zomco/aiontheedge-firmware/cases/DESIGN.md

# 水表光学抄表装置 · 外壳设计文档

> **这是外壳设计的主文档。** 面向接手迭代的 AI 或工程师。
>
> 配套：`wmcase/`（参数化模型 + 自检套件）、[WORKFLOW.md](WORKFLOW.md)（迭代流程）、
> [ASSEMBLY.md](ASSEMBLY.md)（装配说明，由模型生成）、
> [DESIGN_NOTES.md](DESIGN_NOTES.md)（**历史与踩过的坑**，强烈建议先读它的 §7）。
>
> 本文回答"**为什么长这样**"；`params.py` 回答"**是多少**"；
> `checks/` 回答"**怎么知道它对**"。三者不重复，出现矛盾时以代码为准，
> 并**立刻回来改这份文档**。

---

## 目录

1. [项目背景与硬约束](#1-项目背景与硬约束)
2. [坐标系与命名约定](#2-坐标系与命名约定)
3. [数据台账：哪些数字可信](#3-数据台账哪些数字可信)
4. [光学设计](#4-光学设计)
5. [机械设计](#5-机械设计)
6. [防呆设计](#6-防呆设计)
7. [电气与固件接口](#7-电气与固件接口)
8. [代码结构](#8-代码结构)
9. [自检套件](#9-自检套件)
10. [未验证的假设](#10-未验证的假设)
11. [换开发板 / 换表型](#11-换开发板--换表型)
12. [协作规矩](#12-协作规矩)

---

## 1. 项目背景与硬约束

在**不更换既有水表**的前提下，给自建出租房的 **40 块机械水表**加装光学抄表装置，
读数回传 Home Assistant。

| 约束 | 值 | 来源 |
|---|---|---|
| 不能更换水表 | — | 业主要求 |
| 表盘上方净空 | **70mm**（40 台的**最小**值，自银圈顶面起算） | 实测 |
| 单机 BOM | 目标 ≤ 50 元 | 业主预算 |
| 必须保留人工抄表 | 每月 1 日 + 租户争议时 | 业主要求 |
| 端侧完成识别 | 只回传读数 | 业主要求 |

现场：楼梯半层，每层 6 块表垂直排列；表前方净空 1 米以上；
每层一路 5V/10A 电源；楼梯间潮湿（结露风险）。

被测表：宁波埃美柯 **LXSY-15E2**，DN15 旋翼式液封冷水表，
L=165 / B=94 / H=111，G3/4B（数据取自 `amico-lxsy.pdf` 外形尺寸表）。
表盘**朝上**，5 位字轮 + 4 个指针。

> **"表盘朝上"这一条是全设计的起点。** v0.1 曾经按"表盘朝外"设计，整版报废。
> 换表型时第一件要确认的就是这个姿态。

---

## 2. 坐标系与命名约定

**这一节是所有几何讨论的前提，任何时候不要改动。**

```
原点 O  = 水表表盘玻璃面的中心
+X      = 沿水表体轴线（左右方向），整机左右对称
+Y      = 离墙方向（房间一侧）；吊舱、滑盖抽出、整机拆卸都在这一侧
+Z      = 垂直向上；上方净空 70mm 是全项目最紧的约束
```

关键平面（`params.Meter` 的派生量，不要手写）：

| 特征 | Z |
|---|---|
| 表盘玻璃面 | 0 |
| 银圈顶面 | +7.0 |
| 银圈底部凸台顶 | −11.3 |
| 银圈底面 | −14.1 |
| **天花板（障碍物）** | **+77.0** |
| 镜面中心 = 镜头光轴 | +42.0 |
| 镜头前端面 | Y = +80.0 |

### 2.1 旋转必须写出映射并逆向验算

历史上最贵的一类错误是坐标变换复合写反（DESIGN_NOTES §7.1：
整个立板飞到别处，挂在上面的东西全部悬空）。现在的规矩：

**凡是涉及旋转/换系的地方，注释里必须写全映射，并把基准点代回去验算。**

代码里三处坐标系都照做了，格式如下（摘自 `layout.board_location`）：

```
局部 +Xs (PCB 长边)  -> 全局 -Z
局部 +Ys (板厚)      -> 全局 -Y
局部 +Zs (PCB 短边)  -> 全局 -X

逆向验算：Zs = axis_zs -> X = 0 ✓；Ys = lens_face_ys -> Y = 80 ✓；Xs = axis_xs -> Z = 42 ✓
行列式检查：det = +1（纯旋转）。若写成 ez→(+1,0,0)，det = −1 —— 那是镜像，
会把 SD 卡座和排针悄悄挪到另一侧，而板子近似左右对称，看渲染图发现不了。
```

行列式那一条不是形式主义：**开发板近似左右对称，镜像错了肉眼看不出来**，
但 SD 卡座、排针、天线座的位置会全错。

---

## 3. 数据台账：哪些数字可信

`params.py` 里每个字段都有可信度前缀。**改设计前先看清你依赖的是哪一类。**

| 前缀 | 含义 | 改动意味着 |
|---|---|---|
| `[实测]` | 卡尺量过 | 换了一块表 / 一块板 |
| `[采购]` | 规格书 / 样本 | 换了供应商 |
| `[设计]` | 我们自己定的 | **参数搜索的主战场** |
| `[估算]` | 还没验证的假设 | 见 [§10](#10-未验证的假设)，每条都有验证方法 |

### 3.1 表头实测（抱箍与光学的全部基准）

| 项 | 值 |
|---|---|
| 银圈外径 | **82.1 mm** ← 抱箍唯一基准 |
| 银圈内径 | 61.8 mm |
| 银圈高度 | 21.1 mm |
| 可视表盘直径 | **56.5 mm** ← 光学 ROI 基准 |
| 银圈底部凸台 | 宽 9.5 × 高 2.8 |
| 40 台最小净空 | **70 mm** |

### 3.2 开发板（`esp32s3cam-2.step` 实测）

这些数字是用 `python build.py inspect esp32s3cam-2.step` 从 STEP 里量出来的，
抄进了 `params.BoardSpec`；自检 `FIT-05` 会反过来核对，抄错会立刻报错。

| 项 | 值（STEP 局部坐标） |
|---|---|
| PCB | Xs 0→40，Zs 0→27，模型板厚 1.0（实物按 1.6 算间隙） |
| 光轴 | Xs = 8.91（这一侧朝上），Zs = 13.51（≈27/2，天然居中） |
| 镜头前端面 | Ys = 9.07（= 高出 PCB 面 8.07） |
| 摄像头模组本体 | 8.5 × 8.5，Ys 3.04→7.14；镜筒 Ø5.9 再往前 1.93 |
| 前侧深级（SD 卡座 + 排线） | 伸出 PCB 约 2.98mm，集中在 X ±8.3 |
| 前侧浅级（一圈贴片） | 伸出 PCB 约 1.54mm，一直铺到 X ±12.81 |
| 背面 | 模块 3.55mm，排针 9.02mm |

> **⚠ 一条重要修正。** 上一版文档写的是"摄像头模组 27×27mm"，
> 吊舱前腔就是按这个建的。实际从 STEP 量出来，模组本体只有 **8.5×8.5**，
> 27 是整块 PCB 的宽度。按 27 建的前腔既夹不住模组（光轴定位失效），
> 也挡不住 PCB（止挡失效）。**这是"从没验证过的假设"的典型代价。**

---

## 4. 光学设计

### 4.1 核心难题

表盘朝上，上方只有 70mm 净空，而相机需要 100mm 以上工作距离才有可用景深。

**解法：45° 前表面反射镜折叠光路。**

```
表盘 ──垂直上行 42mm──> 45° 反射镜 ──水平前行 80mm──> 镜头
```

总光程 **122mm**，但竖直方向只占用约 60mm；相机与电子件全部移到 +Y
（有 1 米净空），完全不占稀缺的竖直空间。

### 4.2 虚拟相机 —— 全部光学计算的基础

把镜头对 45° 镜面做镜像：

```
L  = (0, lens_face_y, mirror_z) = (0, 80, 42)
镜面：z − y = mirror_z，反射面法线 n = (0, 1, −1)/√2
L' = L − 2·((n̂·L − d)/|n̂|)·n̂ = (0, 0, mirror_z + lens_face_y) = (0, 0, 122)
```

**虚拟相机正悬在表盘中心上方 122mm 处，垂直向下看。**

于是"表盘上某点能不能被看到"退化成：**从该点连一条直线到 (0,0,122)**，
看它与镜面的交点是否落在镜片上、两段路径是否被挡。
三维折叠问题降成两段直线求交 —— `optics.py` 全部计算都基于这个等价。

反射方向验算（写出来接受检查）：

```
d_in = (0,0,1)（上行），n = (0,1,−1)/√2
d_out = d_in − 2(d_in·n)n = (0,0,1) + (0,1,−1) = (0,1,0)  ✓ 向 +Y 前行
```

### 4.3 光学参数与余量

| 量 | 值 | 判据式子 |
|---|---|---|
| 成像半径 ROI_R | 29 mm | 覆盖 Ø56.5 + 余量 |
| 总光程 | 122 mm | `mirror_z + lens_face_y` |
| 光锥在镜面处半径 | 19.02 mm | `roi_r·(1 − mirror_z/path)` |
| 45° 面与光锥交线 | Y ∈ [−24.95, +15.36] | 见 `Optics.ellipse_y` |
| **镜片光学需求** | 57 × 38 mm | `(y₁−y₀)·√2` × `2·beam_r` |
| **镜片采购规格** | **70 × 50 × 2 mm** | 余量 13 / 12 |
| 镜片**有效**口径 | 45.6 mm | 50 − 2×2.2（T 型槽唇口吃掉） |
| 单字符成像 | **44.4 px** | `digit_w·px_h / (2·path·tan(HFOV/2))` |
| 景深半宽 | ±20.5 mm | `N·c·s²/f²`，f=2.77mm，N=2.4，c=4.4µm |
| ROI 半张角 | 13.37° | `atan(roi_r/path)`，需 ≤ min(HFOV,VFOV)/2 = 25.97° |

> **"我算过了"不是证据。** 上表每一行都给出了式子，
> 而且都在 `checks/optical.py` 里有对应规则。
> 历史上至少两次因为手算式子写错而推翻了正确方案（DESIGN_NOTES §7.7）。

### 4.4 反射镜采购规格

| 项 | 要求 |
|---|---|
| 类型 | **前表面反射镜（第一表面镜）** |
| 尺寸 | 70 × 50 × 2 mm |
| 镀层 | 铝 + SiO₂ 保护膜 |
| 反射率 | 可见光 ≥ 88% |

**必须是前表面镜。** 普通背镀镜玻璃前后两次反射产生双像鬼影，
字轮出现重影，OCR 直接失效。镀膜面不可擦拭（只能气吹），
划伤即报废，**建议多买 2 片备用**。

> 曾经建议过"用报废机械硬盘盘片替代" —— **在这个尺寸下不成立**：
> 3.5" 盘片外径 95mm、中心孔 25mm，可用环带只有 35mm 宽，放不下 70×50，
> 而且中心孔会落在光路上。

### 4.5 眩光抑制

表盘是"Ø56.5、深 7mm 的井"，盖着弧面玻璃 + 液封介质。
**同轴照明（板载闪光灯）必然在字轮上打出镜面高光 —— 这是几何问题，调亮度无效。**

解法：**两颗 5mm 草帽白光 LED（120° 全角）置于 (±38, 0, 20)**，射向表盘中心。
（高度 30 → 20 是被托板的可拆性逼下来的，见 §5.3。）

| 检查 | 数值 | 判据 |
|---|---|---|
| 光线越过银圈内缘（ρ=28.25）时的高度 | 14.9 mm | `z(ρ) = z_led·ρ/R_led` |
| 表盘中心入射角 | 62.2° | 采集锥半角仅 13.4°，镜面反射瓣全部打偏 |
| 单颗在最外圈的阴影带 | 几 mm | `井深 × tan(入射角)`，由对侧那颗补上 |

**必须对置两颗，不是冗余而是几何必需。**
LED 型号必须是 **120° 草帽型**：普通 5mm 圆头只有 15~30°，
会打出中心亮斑、四个指针全黑。

**偏振片**：吊舱前壁留了 Ø20 × 1.2 沉孔作为对冲。默认不装；
若现场发现残余眩光，贴一片 Ø20 线偏振片 + LED 前贴一片旋 90° 即可。

### 4.6 ⚠ 画面是镜像的

光路含 **1 次反射**，传感器画面**左右翻转**。

* AI-on-the-edge 标 ROI 时看到的就是翻转后的画面，按翻转后的框；
* 如果要在固件里翻回来，OV2640 有 `set_hmirror()`，
  但**不要一边翻一边又按翻转后标 ROI**，两者只能选一个；
* `out/sensor_view.svg` 画的就是翻转后的画面，可以直接对照。

传感器长轴（1600px）到底对着全局 X 还是 Z，取决于模组内部芯片朝向，
**我们没有可信资料**。所以 `OPT-07` 的判据取 min(HFOV, VFOV)/2，
结论与朝向无关。第一台实物拍一张就能确定，确定后回来更新这一段。

---

## 5. 机械设计

### 5.1 三个打印件

| 件 | 体积 | 作用 |
|---|---|---|
| `body` | ≈129 cm³ | 抱箍 + 撑座 + 立板 + LED 座 + 镜托台 + 吊臂 + 吊舱（**单一连通实体**） |
| `mirror_holder` | ≈30 cm³ | 45° 托板 + 提手 + 两片支承片（**每月抄表整块提起**） |
| `slide_cover` | ≈8 cm³ | 竖直下滑，无螺丝 |

### 5.2 抱箍：整机唯一的机械接口

**曾经的致命错误**（DESIGN_NOTES §7.3）：内孔比银圈大 2.4mm，剖分缝只有 2.2mm，
完全闭合仅缩小 `2.2/π = 0.70mm`，**永远碰不到银圈**。
根源是假设了一个从未列入 BOM 的 1.2mm TPU 衬垫。

现在的方案：

| 项 | 值 | 理由 |
|---|---|---|
| 光孔 | Ø82.8（单边 +0.35） | 便于套入 |
| **16 条内棱** | 内切 Ø81.6（**单边过盈 0.25**） | 只有棱接触，局部压强高十几倍，抗转 |
| 剖分缝 | 4 mm | 留弹性张开行程 |
| 夹持带 | Z −10 ~ +6.5 | 高于底部凸台顶（−11.3），低于银圈顶（+7） |
| 夹紧螺栓 | 两颗 M4 蝶形，z = −6 / +2.5 | 上下受力均匀，防止带子张成 V 形 |
| 备用 | 前侧对称两个 Ø3.2 径向孔 | 棱纹不够时可拧 M4 自攻顶紧 |

**内棱的坑**：16 条棱里若有一条落在剖分缝内，会被切成孤立薄片。
代码里已加过滤，自检 `TOPO-01` 也会兜底。

**关于"校准固化"**：银圈顶部凹台位置逐台不同，说明表头装配角度本身随机，
所以**支架绝对朝向无法也不需要统一** —— 每台 ROI 本来就要在软件里各框一次。
需要保证的只是**同一台反复拆装后角度可复现**：靠抱箍不打滑 + 托板四点销定位。

### 5.3 镜片托板：等高四点支承 + 抬起平推

每月人工抄表时镜片挡住字轮，必须移开。
方案是**只取下这块托板**，而不是移动整个悬臂（那会破坏相机对位）。

动作只有两步：**垂直上提 8mm 脱离定位销 → 沿 +Y 平推出来。**

* 每侧一片**支承片**（X 32~38，厚 6），底边是一条**水平线**（z=20）；
* 落在立板伸出的**两个等高托台**上（都在 z=20）；
* 4 根竖直销约束平面内自由度（间隙 0.2，竖直销零支撑打印）；
* 读完原路放回，ROI 不需要重新标定。

#### ★ 为什么托台必须等高 —— 本次重构最重要的一条发现

上一版按"托板底面是 45° 斜面"的直觉，把前托台放在 z=50、后托台放在 z=20，
支承结构做成"三角耳 + 两只支承脚"。

**每个零件单独看都对，静态干涉检查全过 —— 但整块托板根本拿不出来。**

抽出时，支承结构的**后**半段要扫过**前**托台，而它比前托台低 30mm：

```
后支承脚底面 z = 20，前托台顶面 z = 50
要越过去需要抬升 > 30mm，而天花板只给 11mm
```

这个错误是 `SEQ-02`（抄表流程逐点路径仿真）抓到的。
**静态干涉检查一条都报不出来** —— 因为"装得进去"和"拿得出来"是两回事。

现在两个托台等高、支承片底边水平，抬 8mm 就整体脱离，平推无阻。

| 约束 | 值 | 由谁保证 |
|---|---|---|
| 两托台等高 | 都是 z=20 | `CONS-12` |
| 支承片底边水平且与托台等高 | z=20 | `CONS-12` |
| 支承片外缘 < 立板内侧面 | 38 < 42.5 | `CONS-11` |
| 支承片外缘 < LED 灯座最内缘 | 38 < 约 37.7+ | `SEQ-02` 路径仿真 |
| 托台内伸斜面免支撑 | atan(10.5/12) = 41.2° | `CONS-13` |

#### LED 高度被可拆性拉低了

灯座凸台会伸到 X≈37，正好落在支承片平推的路径上。
所以 LED 从 z=30 降到 **z=20**：凸台随之落到 z<27，支承片抬 8mm 后
（底面 z=28）刚好从它上面掠过。

**光学上反而更好**：表盘中心入射角从 51.7° 增到 62.2°，镜面反射瓣偏得更远；
掠射高度 14.9mm 仍远大于 7mm 井深。

### 5.4 提手：为什么在两边而不在中间

托板要能被一只手提起来，但三个约束同时卡着：

* **不能加高** —— 天花板只剩约 10mm 余量，竖直提手会把提起行程吃掉；
* **不能放中间** —— 中间是 T 型槽的插入口。横穿过去会被槽切断
  （实测：托板裂成 2 个孤立实体，`TOPO-01` 当场报错），也会挡住镜片滑入；
* **不能挡光**。

所以提手做成：两片从支承片前端伸出的**水平**悬臂（X ±32~38，y 18~34，z 58~64）
+ 一根横梁（y 28~34）。径向早已跑出光锥；横梁虽然过中心，
但 z 58~64 高于该处反射光束上缘（y=32 处约 53.8）。
立板前缘只到 y=22，所以横梁所在的 y 28~34 是完全敞开的，手伸得进去。

### 5.5 镜片 T 型槽

反射面朝下，直通方槽会让镜片掉出来。改成 T 型槽：

* 深部 50.2mm 宽容纳镜片；
* 开口收窄到 45.6mm，**两侧各留 2.2mm 唇口**；
* 从局部 −Y 一端滑入（全局方向为斜向上前方）。

**局部 z 的零点定义**（改之前必读 `parts/mirror_holder.py` 顶部）：

```
局部 z = +0.8   唇口外表面
局部 z =  0     ★ 镜片镀膜面 = 光学基准面 z = y + 42
局部 z = −2.0   镜片背面
局部 z = −4.5   托板背面
```

早期版本把零点定在"托板正面"，结果实际反射面比设计平面**退后 0.8mm**，
光线追踪直接打空 —— 这是个**只有射线求交才能发现**的错误，
体积布尔和肉眼都看不出来。

**镜片是在台面上装进托板的，不在现场装。**

### 5.6 滑盖：真正的 C 型槽

**曾经的错误**（DESIGN_NOTES §7.6）：槽只约束 X，盖板可以直接向后掉出来。

现在的结构（沿 Y 从前到后）：

```
Y  ~108.75   侧壁前沿      → 约束 −Y
Y 108.75~112.2  滑槽(X±19.5)  → 盖板舌片(X±19.3)在此，约束 X
Y 112.2~114  后压边(1.8mm) → 约束 +Y
```

盖板从顶部插入，竖直下滑，槽底限位。顶部有 Ø16 手指凹槽。

**主型腔必须贯通到吊舱后表面**，不能封死后端：推荐打印姿态下
（主体绕 X 轴 +90°，+Y 朝上）封死的后端会变成 34×66mm 的大平顶悬空，
远超 15mm 桥接上限。这是 DfAM 决定的结构，不是随便开的口。

### 5.7 吊舱：靠摄像头模组自己定位光轴

不用任何额外零件固定开发板。型腔沿 +Y 分四段：

```
[前壁 3mm，Ø13 镜头孔 + Ø20×1.2 偏振片沉孔]
[摄像头方腔 9.2×9.2 —— 只夹模组本体，光轴的 X/Z 由它决定]
[深级让位槽 X±8.9 —— SD 卡座 + 排线]
[浅级让位槽 X±13.4，Z>18.8 —— 一圈贴片元件]
┃ ← PCB 前表面止挡（落在 Z<18.8 那条前侧完全干净的下缘带上）
[主型腔 —— 板卡、天线、驱动板、走线]
[滑盖]
```

板卡六个自由度：

| 自由度 | 靠什么 | 自检 |
|---|---|---|
| −Y | PCB 前表面顶在台阶上 | CONS-07 |
| +Y | 滑盖内侧 EVA 泡棉顶住 | FIT-09 |
| ±X | 两条侧向导轨（单边间隙 0.4） | CONS-08 |
| −Z | 板下缘落在承台上 | CONS-09 |
| +Z | 重力 + 泡棉摩擦 | — |
| 绕轴 | 导轨 + 承台构成三点约束 | CONS-08/09 |

**止挡面为什么落在下缘带而不是四周一圈**：前侧贴片元件一直铺到 X ±12.81，
而 PCB 只有 ±13.5，两侧根本剩不下台阶；只有 Z < 19.36 那一段前侧完全干净
（27 × 8mm），足够做止挡。这条结论是从 STEP 里一格一格量出来的。

用软泡棉而不是硬定位，是因为板背面元件高度存在公差，硬顶会翘板。
**副作用是好的：镜头位置由摄像头模组在方腔里的落位决定，而不是由 PCB 决定，
光学重复精度反而更高。**

### 5.8 走线

全部内藏，外表面无可见线缆：

```
LED 座孔 → 引线过孔 → 立板内侧竖槽 → 横槽 → 吊臂 U 型腔 → 吊舱电子舱
5V 电源 → 吊舱底面水滴孔（朝下，防结露倒灌）
```

吊臂做成**下开口 U 型槽**（壁厚 2.5mm），线走在腔内，从下方才看得见。
同时满足三件事：走线路径、DfAM"禁止实心大块"、比刚度高于实心杆。

自检 `WIRE-02` 把整条路径上的空腔并起来查连通域数 —— 这是把 `TOPO-01`
的思路用在"洞"上：**每一段都挖了 ≠ 它们连成一条**。

### 5.9 DfAM 落实（对齐 `dfam_rules.md`）

| 准则 | 落实 |
|---|---|
| 悬垂 ≥45° | 撑座 loft 约 64°、托台斜撑、吊臂顶壁 ≤4mm 桥接 |
| 水平孔水滴形 | `geometry.teardrop_z`，用于底部进线孔 |
| 功能特征代支撑 | 撑座本身即加强结构 |
| 禁止实心块 | 吊舱抽壳 2.5mm、吊臂 U 型、立板 7mm 板状 |
| 圆角过渡 | 外轮廓 R3、吊舱边 R3、其余 R1.2~2 |
| 运动/静态间隙 | 滑盖舌槽 0.25、定位销 0.2、PCB 0.3~0.4 |
| 各向异性 | 立板为板状件，主拉应力在层内 |
| 非流形 | 全局 `EPS=0.01`，所有减法体加微元 |

**推荐打印姿态**（`checks/dfam.py: PRINT_ORIENTATION`，悬垂统计就按它算）：

| 件 | 姿态 | 理由 |
|---|---|---|
| `body` | 绕 X 轴 **+90°**（+Y 朝上） | 吊舱腔口朝上零支撑；镜头孔变竖直孔；立板层向平行于弯曲中性面 |
| `mirror_holder` | 绕 X 轴 **+135°** | 45° 反射面朝正上，T 型槽朝上零支撑 |
| `slide_cover` | 绕 X 轴 **+90°** | 平放 |

---

## 6. 防呆设计

防呆分三层，**只有第一层能被机器验证**：

| 层次 | 说明 | 本设计里的实例 | 可验证 |
|---|---|---|---|
| **几何** | 装反就是装不进去 | LED 极性切边、滑盖定位筋、前腔 Z 不对称 | ✅ `POKA-02/03/04/05` |
| **导向** | 装错会明显别扭 | 方腔入口倒角、PCB 侧导轨、托板落座感 | 只能人工体会 |
| **标识** | 刻字提醒 | 托板横梁 `COATED SIDE DOWN` | ℹ️ `POKA-06` 仅记录 |

### 6.1 LED 极性（最硬的一处）

真实草帽灯法兰上有一条切边标记阴极（`led.step` 实测：法兰 Ø5.8，切边距轴心 2.4）。
座孔做了同样的切边（Ø6.0，切边距轴心 2.5）。

装反时法兰被挡 `2.90 − 2.50 = 0.40mm` —— 不靠标识、不靠说明书，**靠形状**。

> **判据要用线性量，不能用体积。** 法兰只有 1mm 厚，转 180° 后的干涉体积
> 不到 1mm³，和布尔噪声容差（2mm³）分不开。这个坑值得记一笔：
> **反向判据的阈值必须比正向判据的容差高一个量级，否则那条检查是假的。**

### 6.2 滑盖定位筋

+X 滑槽底部有一条 10mm 长的筋，盖板 +X 舌片的**最下面一段**相应收窄。

* 正装 → 筋落进收窄段，无阻碍；
* 上下颠倒 → 收窄段跑到顶部且换到 −X 侧 → 满宽舌片撞上筋；
* 前后调头 → 收窄段换到 −X 侧 → 同样撞。

**筋必须紧贴槽底。** 放在中段会把正装也一起挡住 —— 盖板从上往下滑，
舌片的满宽部分下滑时一定会先经过中段的筋。
（这个错误第一版就犯了，`SEQ-01` 装配第 9 步立刻报了出来。）

### 6.3 开发板方向

前腔在 Z 方向**不对称**（SD 卡座偏上、排线尾端偏下），
板子上下颠倒或前后调头都会顶到台阶。
如果哪天让位槽被改成上下对称，`POKA-04` 会立刻报错 —— 那正是它的用处。

### 6.4 镜片朝向：诚实地标为"做不到"

前表面镜必须镀膜面朝下。但它是**一块两面一样的矩形玻璃，做不成几何防呆**。
所以：

* 托板横梁上刻 `COATED SIDE DOWN`；
* `ASSEMBLY.md` 第 11 步有对应的检查动作；
* 识别方法：**用笔尖轻触镜面，笔尖和倒影没有间隙的那面才是镀膜面。**

把这一条标成 `INFO` 而不是假装解决了 —— 假的安全感比已知的风险更危险。

---

## 7. 电气与固件接口

外壳设计只关心三件事，其余见 [DESIGN_NOTES.md §6](DESIGN_NOTES.md)：

1. **LED 驱动板位置**：15×20mm 洞洞板（AO3400 + 100Ω×2 + 100k），
   装在吊舱**下部电子舱**（Z < 10），远离光学部分；
   通往 LED 的只有两根简单导线。
   > 白光 LED 的 Vf ≈ 3.0~3.2V，而 GPIO 高电平只有 3.3V，
   > 压差不够限流电阻工作，**必须**从 5V 供电、GPIO 只控栅极。
2. **天线**：FPC 65×15 贴 +X 内壁的定位框，馈点朝上。
3. **进线**：底面水滴孔，**朝下**，防止楼道结露沿线倒灌。

固件侧需要知道的：[§4.6 画面是镜像的](#46--画面是镜像的)。

---

## 8. 代码结构

```
params.py     纯数字（实测/采购/设计/估算），**唯一允许出现尺寸的地方**
    ↓
layout.py     尺寸链：参数 → 位置与基准面。判据式子写在注释里
    ↓
geometry.py   建模原语：按起止坐标建体、mirror_x、水滴孔、带切边的圆柱
    ↓
parts/*.py    三个打印件      refs.py  参考件（按可信度分级）
    ↓
model.py      Design：一次配置的全部实体，带缓存
    ↓
checks/*.py   自检     optics.py 光路仿真     export.py 导出     report.py 报告
```

**依赖方向严格自上而下，不许反向。**

三条编码规矩（违反了很难被发现，所以写死在这里）：

1. **建模函数里不许写魔法数字。** 要新尺寸就去 `params.py` 加字段。
2. **左右对称一律用 `geometry.mirror_x`**，不许写 `for s in (-1, 1)`。
   `cube` 只向 +X 生长，`s*X` 乘号会让 −X 侧的槽跑到对侧表面
   （DESIGN_NOTES §7.2）。用镜像算子让"左右不对称"在语法上不可能。
3. **实体一律用起止坐标定义**（`bx(x0,x1,y0,y1,z0,z1)`），不用"中心+尺寸"。

`parts/body.py` 还有一条结构性规矩：**先加料、再一次性去料、最后长内部特征**。
吊臂在吊舱端会伸进主型腔，若先挖腔再并吊臂，腔里会留下一坨实心料，
正好挡在板卡旁边 —— 这种错误在渲染图上几乎看不见。

---

## 9. 自检套件

110+ 条规则，10 个分类。设计哲学三条：

### 9.1 拓扑检查是性价比最高的

```python
len(part.solids()) == 1
```

一行代码消灭了折磨了十几个版本的整个错误类别（零件悬空）。
CAD 的 union 对不相接的实体一样能编译通过，**没有任何警告**。

### 9.2 不只查"不干涉"，还要证明"约束成立"

`A ∩ B = 0` 只说明装得进去，不说明装上后不会掉。每个约束都配**反向测试**：

| 正向 | 反向 |
|---|---|
| 主体 ∩ 托板 = 0 | 托板下沉 0.5mm **应当**干涉 |
| 主体 ∩ 滑盖 = 0 | 滑盖前后各推 0.6mm **应当**干涉 |
| 托板 ∩ 镜片 = 0 | 镜片外推 1.2mm **应当**干涉 |
| 主体 ∩ 板卡 = 0 | 板卡前推/侧推/下沉 **应当**干涉 |

§7.5 的"托台顶死托板"，**只有反向测试能自动抓住**。

### 9.3 把空间想象题变成可计算判据

* **光路**：做成实体（体积粗筛）+ 逐点射线追踪（精确定位）；
* **装配顺序**：写成 `assembly.py` 的路径数据，沿路径逐点做布尔；
* **走线**：把路径上的空腔并起来查连通域；
* **净空**：三角化成点云，逐点核算"表盘正上方区域"内的最高点。

### 9.4 分类

| 分类 | 管什么 | 典型规则 |
|---|---|---|
| `TOPO` | 拓扑 | 单一连通实体、is_valid、体积量级 |
| `FIT` | 装得进去吗 | 件间干涉、板卡包络、模组在方腔里、泡棉够不够厚 |
| `CONS` | 装上会不会掉 | **全部是反向测试** |
| `SEQ` | 按这个顺序装得起来吗 | 沿路径碰撞 + 全程净空 |
| `OPT` | 相机看得见吗 | 逐点光线追踪、有效口径、字符像素、景深、渐晕 |
| `LED` | 会不会有高光/阴影 | 掠射高度、入射角、反射瓣偏离量 |
| `DIM` | 尺寸链 | 抱箍过盈、夹持带位置、天花板、打印空间 |
| `DFAM` | 打得出来吗 | 悬垂面积占比、壁厚采样 |
| `POKA` | 装反了会怎样 | **全部是反向判据：必须装不进去** |
| `WIRE` | 线走得通吗 | 空腔连通域 |

### 9.5 加一条规则

```python
@rule("OPT-11", "OPT", "标题",
      why="这条规则存在的理由 —— 通常指向 DESIGN_NOTES 里的某个坑")
def my_check(design):
    v = inter_vol(design.body, something)
    return v < design.cfg.mfg.vol_tol, f"{v:.2f} mm³"
```

`why` 不是装饰：报告里失败项会把它一起打出来，
下一个接手的人看到 FAIL 不用猜"这条到底在防什么"。

**新增了结构就要新增对应的检查。** 这是提交的前提。

### 9.6 已知的局限

* **壁厚**和**悬垂**都是**采样**方法，不是证明。能拦住明显问题，
  不能替代切片器预览。
* **桥接跨度**没有自动检查。
* **重心 / 悬臂挠度**没有估算。
* `watermeter-dn25.step` 是 DN25，**任何判定都不许引用它**；
  判定用的是 `refs.meter_mock()`（卡尺实测参数化）。

---

## 10. 未验证的假设

按风险从高到低。**每一条在 `params.py` 里都标了 `[估算]`。**

| # | 假设 | 风险 | 验证方法 |
|---|---|---|---|
| 1 | **蓝盖翻开后停在哪**（`cover_park_y` / `cover_open_top`） | 光学读表要求蓝盖常开；而托板为了接住表盘外缘的光必须伸到 y≈−31，两者非常接近。自检 `FIT-14` 已经报出重叠 | 把蓝盖翻到平时停放的位置，量最外缘 Y 和最高点 Z |
| 2 | `glass_depth = 7mm`（银圈顶→玻璃面） | 影响**全部 Z 基准** | 深度尺插到玻璃面 |
| 3 | 抱箍单边过盈 0.25 合适 | 太紧装不上，太松打滑 | **优先只打抱箍试配** |
| 4 | 吊舱正上方无障碍 | 滑盖抽出需 70mm 净空 | 现场目视 |
| 5 | 传感器长轴朝向 | 影响 ROI 框法（不影响能否成像） | 第一台拍一张 |
| 6 | 手电筒实验"字轮无高光" | 未验证四个指针是否都照到 | 按 (±38,0,30) 位置重做 |
| 7 | EVA 泡棉 20mm 的压紧效果 | 太软板卡会晃 | 试装后摇一摇 |

**建议验证顺序**：1 → 3 → 2 → 6 → 4，前三项过了再打整机。

> 第 1 条现在排到最前面：`FIT-14` 已经报出托板和蓝盖停放带有重叠。
> 如果实测证实撞上，可选的出路是（按优先级）：把蓝盖整个卸掉、
> 换一个停放角度、或者把托板的后端裁短并相应缩小 ROI。
> **在量到真实数字之前，不要围绕任何一种猜测去改设计。**

---

## 11. 换开发板 / 换表型

### 11.1 换开发板（适配 `esp32s3cam-1` / `-3`）

```bash
python build.py inspect esp32s3cam-1.step     # 量出包络与子件清单
# 把数字填进 params.BOARDS 里的一条新 BoardSpec
python build.py check --board esp32s3cam-1
```

要量的（对应 `BoardSpec` 的字段）：

1. PCB 的三向范围、板厚；
2. 光轴位置（摄像头模组本体的中心），**注意哪一侧朝上**；
3. 镜头前端面、模组本体前/后端面、镜筒直径；
4. 前侧深级/浅级元件的包络（决定两级让位槽）；
5. 背面最高元件的伸出量。

`FIT-05` 会拿真实 STEP 反过来核对包围盒，抄错会立刻报错。

### 11.2 换表型

只改 `params.Meter` 一段。其余尺寸链会自动跟随，并被 `DIM-01~04` 拦一遍。
但要先确认两件事：

1. **表盘姿态**是不是朝上（不是的话整个架构都要重来）；
2. 银圈外径、可视表盘直径、上方净空，这三个是全部设计的基准。

---

## 12. 协作规矩

### 12.1 提交前

```bash
python build.py check          # 阻断性失败必须为 0
```

有新增结构就要有新增自检项。`out/report.md` 一起提交，方便做版本间 diff。

### 12.2 给下一个 AI 的六条

1. **先读 [DESIGN_NOTES.md §7](DESIGN_NOTES.md)，再动手。** 那些错误机制会重演。
2. **不要相信自己的空间想象。** 把每个几何判断写成可计算的判据放进自检。
   十三个版本的统计事实：可手算复核的东西出错率低且能自我发现；
   需要空间想象的东西出错率高且**不能**自我发现。
3. **看不到渲染结果就明说。** 本项目所有结构性错误都是人发现的。
4. **收到推翻自己判断的数据时，先追问测量语义**，不要直接采信
   （§7.4：一个"300mm"让整版设计报废）。
5. **给出的判据式子要写出来。** "我算过了"不是证据。
6. **做减法。** 每加一个结构，问"没有它会怎样"。

### 12.3 三条容易踩的工具坑（都是这一版踩出来的）

* **`import_step` 返回的嵌套 Compound 直接做布尔会静默返回空集**，
  所有干涉检查一起"通过" —— 最危险的假阴性。
  凡是要参与布尔的 STEP，必须走 `refs.load_step_fused()`。
  发现它的线索是：三条互相独立的检查同时报出同一个可疑的 0。
* **反向判据的阈值要比正向容差高一个量级**，否则那条检查是假的（§6.1）。
* **`Axis` 求交返回的是整条直线的交点，包含反向**，必须自己按参数 t 过滤，
  否则相机后方的结构件会被误判成遮挡物。

### 12.4 单机采购清单

| 项 | 规格 | 估价（元） |
|---|---|---|
| ESP32-S3-CAM | N16R8，IPEX 座 | 34 |
| 前表面反射镜 | 70×50×2，铝+SiO₂ | 10 |
| FPC 天线 | 65×15，IPEX 尾线 50mm | 3 |
| 白光 LED | 5mm 草帽 120° ×2 | 0.2 |
| AO3400 + 电阻 | ×1 + 100Ω×2 + 100k×1 | 0.5 |
| M4 蝶形螺丝 | ×2 | 1 |
| EVA 泡棉 | 20mm 厚，27×40 一块 | 0.5 |
| 打印件 | PETG 约 205g（三件） | 9 |
| 电源/线材分摊 | | 6 |
| **合计** | | **约 64** |

超出 50 元目标约 14 元，主要增量来自反射镜和打印件重量。
压回去的方向：镜片改 60×40（光学实需 57×38，余量收紧）、
吊舱进一步抽壳减重（目前 body 164g 偏重）。

---

*本文档随模型同步更新。改了模型没改文档，等于没改。*
