zomco/aiontheedge-firmware/cases/out/report.md

# 自检报告

生成时间：2026-09-08 20:53:48
开发板：`esp32s3cam-2.step`（可信度 authoritative）
水表：LXSY-15E2　DN15　银圈 Ø82.1

## 结论

- 共 **117** 项检查
- 阻断性失败 **0** 项（可以导出）
- 警告 **2** 项

## 关键数值

| 量 | 值 |
|---|---|
| 总光程 | 122 mm |
| 虚拟相机位置 | (0.0, 0.0, 122.0) |
| 单字符成像 | 44.4 px |
| 景深半宽 | ±20.5 mm |
| 镜片光学需求 | 57.0 × 38.0 mm |
| 镜片采购规格 | 70 × 50 × 2 mm |
| 抱箍单边过盈 | 0.25 mm |
| 打印件体积 | body 128.6 cm³，mirror_holder 30.2 cm³，slide_cover 7.7 cm³ |

## TOPO · 拓扑

| | 编号 | 检查项 | 数值 |
|---|---|---|---|
| ✅ | `TOPO-01` | body 是单一连通实体 | solids=1 |
| ✅ | `TOPO-01` | mirror_holder 是单一连通实体 | solids=1 |
| ✅ | `TOPO-01` | slide_cover 是单一连通实体 | solids=1 |
| ✅ | `TOPO-02` | body 拓扑有效 |  |
| ✅ | `TOPO-02` | mirror_holder 拓扑有效 |  |
| ✅ | `TOPO-02` | slide_cover 拓扑有效 |  |
| ✅ | `TOPO-03` | body 体积在合理区间 | 128.6 cm³（期望 60.0~220.0） |
| ✅ | `TOPO-03` | mirror_holder 体积在合理区间 | 30.2 cm³（期望 10.0~60.0） |
| ✅ | `TOPO-03` | slide_cover 体积在合理区间 | 7.7 cm³（期望 3.0~25.0） |
| ✅ | `TOPO-04` | body 可网格化为 3MF | 三角面 17230 个 |
| ✅ | `TOPO-04` | mirror_holder 可网格化为 3MF | 三角面 14334 个 |
| ✅ | `TOPO-04` | slide_cover 可网格化为 3MF | 三角面 2564 个 |

## FIT · 配合与干涉

| | 编号 | 检查项 | 数值 |
|---|---|---|---|
| ✅ | `FIT-01` | 主体 ∩ 镜片托板 = 0 | 0.73 mm³ |
| ✅ | `FIT-02` | 主体 ∩ 滑盖 = 0（滑盖能就位） | 0.00 mm³ |
| ✅ | `FIT-03` | 镜片托板 ∩ 镜片 = 0（镜片装得进 T 型槽） | 0.00 mm³ |
| ✅ | `FIT-04` | 镜片能从 T 型槽端口滑入 / 滑出 | 滑出 20/40/60/80mm 最大干涉 0.00 mm³ |
| ✅ | `FIT-05` | 开发板 STEP 与 BoardSpec 对得上 | 包围盒最大偏差 0.00mm（容差 0.3） 实测 (-0.500000000000001, -9.012157883070968, 0.0)~(40.0, 9.069765130223479, 27.0) |
| ✅ | `FIT-06` | 开发板 ∩ 主体 = 0（装得进吊舱） | 0.00 mm³ |
| ✅ | `FIT-07` | 开发板完全落在型腔包络内 | X[-13.5,13.5] Y[80.0,98.1] Z[10.9,51.4] vs 腔 X±17.0 Y[79.5,109.0] Z[-9.0,57.0] |
| ✅ | `FIT-08` | 摄像头模组落在方腔里（光轴由方腔定位） | 模组包络 X[-4.19,4.18] Z[37.82,46.19] vs 方腔 X±4.60 Z[37.40,46.60]；单边间隙 0.41mm（= 光轴的 X/Z 重复精度） |
| ✅ | `FIT-09` | EVA 泡棉能压住板卡（+Y 约束成立） | 盖板前表面 109.0 − 板卡最后端 98.69 = 间隙 10.31mm；泡棉 12.0mm → 压缩量 1.69mm（要求 0.5~6.0） |
| ✅ | `FIT-10` | 泡棉不与主体 / 天线打架 | 0.00 mm³ |
| ✅ | `FIT-11` | 灯珠本体 ∩ 主体 = 0（能压进灯座） | 0.00 mm³ |
| ✅ | `FIT-12` | 抱箍内棱对银圈**有**过盈（真的夹得住） | 夹持带内干涉体积 42.02 mm³（内棱咬进银圈漆面） |
| ✅ | `FIT-13` | 抱箍不碰水表表体 | 0.00 mm³ |
| ⚠️ | `FIT-14` | 蓝盖翻开停放的空间不被占用 | 主体重叠 0.00 mm³，托板重叠 87.05 mm³；停放带 Y[-46.0,-33.0] Z[7.0,67.0] （**估算值**，需实测蓝盖停放位置） |

> **FIT-14 失败** —— 这条规则存在的理由：光学读表要求蓝盖**常开**并朝墙侧停放。它停在哪、有多高，目前全是照片目测（params.Meter.cover_park_y / cover_open_top）。而镜片托板为了接住表盘外缘的光，必须一直伸到 y≈−31，两者非常接近。结论只和那两个估算值一样可信，所以是 WARN 不是 ERROR —— 写成 ERROR 会给人虚假的安全感。**这是当前风险最高的一条未验证假设。**

## CONS · 约束有效性

| | 编号 | 检查项 | 数值 |
|---|---|---|---|
| ✅ | `CONS-01` | 托板确实坐在托台上（不是悬空） | 下沉 0.5mm 产生干涉 51.92 mm³ |
| ✅ | `CONS-02` | 托板 +X 向平移 1mm 应当干涉 | 79.43 mm³ |
| ✅ | `CONS-02` | 托板 −X 向平移 1mm 应当干涉 | 79.43 mm³ |
| ✅ | `CONS-02` | 托板 +Y 向平移 1mm 应当干涉 | 78.01 mm³ |
| ✅ | `CONS-02` | 托板 −Y 向平移 1mm 应当干涉 | 76.62 mm³ |
| ✅ | `CONS-03` | 镜片被 T 型槽唇口兜住（镜面朝下不会掉） | 镜片外推 1.2mm 产生干涉 215.60 mm³ |
| ✅ | `CONS-04` | 滑盖 −Y（被前沿挡住） | 201.42 mm³ |
| ✅ | `CONS-04` | 滑盖 +Y（被后压边挡住） | 162.82 mm³ |
| ✅ | `CONS-05` | 滑盖 +X 向平移 0.8mm 应当干涉 | 118.49 mm³ |
| ✅ | `CONS-05` | 滑盖 −X 向平移 0.8mm 应当干涉 | 126.07 mm³ |
| ✅ | `CONS-06` | 滑盖到底有限位（不会继续往下掉） | 下沉 3mm 产生干涉 286.64 mm³ |
| ✅ | `CONS-07` | 板卡的 −Y 被前腔台阶止住 | 板卡前推 1mm 产生干涉 267.49 mm³ |
| ✅ | `CONS-08` | 板卡 +X 向平移 1.2mm 应当干涉 | 43.09 mm³ |
| ✅ | `CONS-08` | 板卡 −X 向平移 1.2mm 应当干涉 | 50.45 mm³ |
| ✅ | `CONS-09` | 板卡的 −Z 落在承台上 | 板卡下沉 1.5mm 产生干涉 59.18 mm³ |
| ✅ | `CONS-10` | 后托台顶面低于托板底面最低点 | 托台顶 20.0 ≤ 22.0 − 2.0 = 20.0 |
| ✅ | `CONS-10` | 前托台顶面低于托板底面最低点 | 托台顶 20.0 ≤ 52.0 − 2.0 = 50.0 |
| ✅ | `CONS-11` | 托板支承片止于立板内侧面之前 | 支承片外缘 38.0 < 立板内面 42.5 |
| ✅ | `CONS-12` | 两个托台等高，托板支承面是一条水平底边 | 后托台 20.0 / 前托台 20.0；支承片底边 z=20 |
| ✅ | `CONS-13` | 托台内伸斜面在免支撑角度内 | atan((42.5 − 32.0) / 12.0) = 41.2° ≤ 45.0° |

## SEQ · 装配 / 拆卸顺序

| | 编号 | 检查项 | 数值 |
|---|---|---|---|
| ✅ | `SEQ-01` | [装配1] 主体套上银圈，压到夹持带下沿到位 | 路径最大干涉 0.00 mm³（忽略 meter） |
| ✅ | `SEQ-01` | [装配7] 从吊舱后方推入 ESP32-S3-CAM | 路径最大干涉 0.00 mm³ |
| ✅ | `SEQ-01` | [装配9] 滑盖从吊舱顶部插入，竖直下滑到底 | 路径最大干涉 0.00 mm³ |
| ✅ | `SEQ-01` | [装配12] 把镜片托板垂直落到四根定位销上 | 路径最大干涉 0.73 mm³ @ 偏移 (0, 0, 0) 撞到 body |
| ✅ | `SEQ-01-CLR` | [装配1] 运动过程不撞天花板 | 表盘正上方区域内的路径最高点 z=72.4 < 天花板 77.0 |
| ✅ | `SEQ-01-CLR` | [装配7] 运动过程不撞天花板 | 表盘正上方区域内的路径最高点 z=-1000000000.0 < 天花板 77.0 |
| ✅ | `SEQ-01-CLR` | [装配9] 运动过程不撞天花板 | 表盘正上方区域内的路径最高点 z=-1000000000.0 < 天花板 77.0 |
| ✅ | `SEQ-01-CLR` | [装配12] 运动过程不撞天花板 | 表盘正上方区域内的路径最高点 z=74.1 < 天花板 77.0 |
| ✅ | `SEQ-02` | [抄表1] 握住托板横梁，垂直上提 8mm 脱离定位销 | 路径最大干涉 0.73 mm³ @ 偏移 (0, 0, 0) 撞到 body |
| ✅ | `SEQ-02` | [抄表2] 提起后沿 +Y 平移取出 | 路径最大干涉 0.00 mm³ |
| ✅ | `SEQ-02` | [抄表4] 原路放回，确认四根销都进孔、托板不晃 | 路径最大干涉 0.73 mm³ @ 偏移 (0, 0, 0) 撞到 body |
| ✅ | `SEQ-02-CLR` | [抄表1] 运动过程不撞天花板 | 表盘正上方区域内的路径最高点 z=74.1 < 天花板 77.0 |
| ✅ | `SEQ-02-CLR` | [抄表2] 运动过程不撞天花板 | 表盘正上方区域内的路径最高点 z=74.1 < 天花板 77.0 |
| ✅ | `SEQ-02-CLR` | [抄表4] 运动过程不撞天花板 | 表盘正上方区域内的路径最高点 z=74.1 < 天花板 77.0 |
| ✅ | `SEQ-03` | [拆卸1] 取下镜片托板（同抄表流程） | 路径最大干涉 0.73 mm³ @ 偏移 (0, 0, 0) 撞到 body |
| ✅ | `SEQ-03` | [拆卸3] 整机垂直上提 18.5mm 脱离银圈 | 路径最大干涉 0.00 mm³（忽略 meter） |
| ✅ | `SEQ-03-CLR` | [拆卸1] 运动过程不撞天花板 | 表盘正上方区域内的路径最高点 z=74.1 < 天花板 77.0 |
| ✅ | `SEQ-03-CLR` | [拆卸3] 运动过程不撞天花板 | 表盘正上方区域内的路径最高点 z=72.4 < 天花板 77.0 |
| ✅ | `SEQ-04` | 取下托板后整机能抬到脱离银圈而不撞天花板 | 表盘上方最高点 53.9 + 抬升 18.5 = 72.4 < 天花板 77.0 |
| ✅ | `SEQ-05` | z=-6.0 处螺栓有徒手操作空间 | 0.00 mm³ |
| ✅ | `SEQ-05` | z=2.5 处螺栓有徒手操作空间 | 0.00 mm³ |

## OPT · 光学

| | 编号 | 检查项 | 数值 |
|---|---|---|---|
| ✅ | `OPT-01` | 表盘每一处都能经反射镜到达镜头 | 58/58 条光线畅通 |
| ✅ | `OPT-01-USE` | 镜片实际用到的范围 | 沿 45° 斜面 55.4mm（采购 70），沿 X 38.1mm（采购 50）；落点 Y∈[-24.1,15.0] |
| ✅ | `OPT-02` | 镜片有效口径（扣掉 T 型槽唇口）够用 | 有效口径 45.6 = 镜宽 50 − 2×唇口 2.2；光学需 38.0（要求余量 ≥4mm） |
| ✅ | `OPT-03` | 采购镜片长度够用（含 5mm 余量） | 需 57.0，采购 70 |
| ✅ | `OPT-04` | 受保护光锥 ∩ 主体 = 0 | 0.00 mm³ |
| ✅ | `OPT-05` | 受保护光锥 ∩ 托板的耳/脚/提手 = 0 | 0.00 mm³ |
| ✅ | `OPT-06` | 单个字轮数字的成像宽度 ≥ 20px | 44.4 px（下限 20） |
| ✅ | `OPT-07` | 整个表盘落在画幅内（按较小的垂直视场算） | ROI 半张角 13.37° ≤ 25.97° − 3°（VFOV=51.9°） |
| ✅ | `OPT-08` | 景深覆盖表盘井深 | 景深半宽 ±20.5mm ≥ 井深 7.0mm（f=2.77, N=2.4） |
| ✅ | `OPT-09` | 镜头孔不产生渐晕 | 孔半径 6.5 ≥ 需 4.90 + 1.0 |
| ✅ | `OPT-10` | 画面是镜像的 —— 固件侧必须知道 | 光路含 1 次反射 → 传感器画面左右镜像；ROI 标定与固件配置见 DESIGN.md §4.6 |

## LED · 照明

| | 编号 | 检查项 | 数值 |
|---|---|---|---|
| ✅ | `LED-01` | LED 必需出射锥 ∩ 主体 ≈ 0 | 0.00 mm³（灯座根部允许微量） |
| ✅ | `LED-02` | 光线能越过银圈内缘照进表盘井里 | z(28.25) = 20.0 × 28.25 / 38.0 = 14.87mm > 井深 7.0 + 3 |
| ✅ | `LED-03` | 灯珠发光角覆盖整个表盘 | 灯珠半角 60° ≥ 需 21° |
| ✅ | `LED-04` | 镜面反射瓣打不进采集锥（不会出现高光） | 表盘中心入射角 62.2°，采集锥半角 13.4°，余量 48.9°（要求 >5°） |
| ✅ | `LED-05` | 两颗对置 LED —— 阴影互补 | 单颗在最外圈投出的阴影带约 3.4mm 宽 （井深 7.0 × tan26.0°），由对侧那颗补上 |
| ✅ | `LED-06` | 灯珠不侵入受保护光锥 | 0.00 mm³ |

## DIM · 尺寸链与净空

| | 编号 | 检查项 | 数值 |
|---|---|---|---|
| ✅ | `DIM-01` | 抱箍内棱的过盈量在可用区间 | 银圈半径 41.05 − 内棱内切半径 40.80 = 单边过盈 0.25mm |
| ✅ | `DIM-02` | 夹持带避开银圈底部凸台 | 带底 -10.0 > 凸台顶 -11.3 |
| ✅ | `DIM-03` | 夹持带不超过银圈顶面 | 带顶 6.5 < 银圈顶 7.0 |
| ✅ | `DIM-04` | 夹持带高度容得下两颗 M4 且受力均匀 | 螺栓 z=(-6.0, 2.5)，带 [-10.0, 6.5]；间距 8.5（≥8），上下边距 4.0/4.0（≥2） |
| ✅ | `DIM-05` | 表盘正上方的最高点低于天花板 | 最高点 zmax=66.1（托板）< 天花板 77.0 |
| ✅ | `DIM-06` | 镜片托板提起 8mm 后仍不撞天花板 | 托板最高 66.1 + 提起 8.0 = 74.1 < 77.0 |
| ✅ | `DIM-07` | 光学基准链自洽 | path 122.0 = mirror_z 42.0 + lens_face_y 80.0；虚拟相机 (0.0, 0.0, 122.0) |
| ✅ | `DIM-08` | 吊舱型腔比板卡包络大一圈 | X 单边 3.50，Z 下 19.91，Z 上 6.09（要求 ≥0.3） |
| ✅ | `DIM-09` | body 装得下 256³ 打印空间 | 99×162×74mm |
| ✅ | `DIM-09` | mirror_holder 装得下 256³ 打印空间 | 76×68×55mm |
| ✅ | `DIM-09` | slide_cover 装得下 256³ 打印空间 | 39×3×70mm |
| ✅ | `DIM-10` | 打印总重与 BOM 估算一致 | 三件合计约 212g（body 163g，mirror_holder 38g，slide_cover 10g） |

## DFAM · 可制造性

| | 编号 | 检查项 | 数值 |
|---|---|---|---|
| ⚠️ | `DFAM-01` | body 悬垂面积占比 | 11.83%（7012/59259 mm²，阈值 4%） |
| ✅ | `DFAM-01` | mirror_holder 悬垂面积占比 | 1.75%（341/19521 mm²，阈值 4%） |
| ✅ | `DFAM-01` | slide_cover 悬垂面积占比 | 0.00%（0/5945 mm²，阈值 4%） |
| ✅ | `DFAM-02` | body 壁厚采样不低于 0.8mm | 400 个采样点，最小 1.21mm，低于下限的占 0.0% |
| ✅ | `DFAM-02` | mirror_holder 壁厚采样不低于 0.8mm | 400 个采样点，最小 0.62mm，低于下限的占 1.0%，最薄处约在 (24, 4, 46) |
| ✅ | `DFAM-02` | slide_cover 壁厚采样不低于 0.8mm | 400 个采样点，最小 2.92mm，低于下限的占 0.0% |
| ✅ | `DFAM-03` | body 边数统计 | 866 条边；内圆角靠 fillet_in=1.2 参数保证，人工在切片预览里复核 |
| ✅ | `DFAM-03` | mirror_holder 边数统计 | 912 条边；内圆角靠 fillet_in=1.2 参数保证，人工在切片预览里复核 |
| ✅ | `DFAM-03` | slide_cover 边数统计 | 42 条边；内圆角靠 fillet_in=1.2 参数保证，人工在切片预览里复核 |
| ✅ | `DFAM-04` | 水平孔已做水滴形处理 | 底部总进线孔 Ø6.5 已用 teardrop_z 生成，尖角朝 +Y（= 打印姿态的『上』） |

> **DFAM-01 失败** —— 这条规则存在的理由：dfam_rules §1：最大悬垂角 45°。贴床的底面不算悬垂，所以要把最低那一层排除掉，否则每个零件都会假报一大片。

## POKA · 防呆

| | 编号 | 检查项 | 数值 |
|---|---|---|---|
| ✅ | `POKA-01` | 镜片托板前后调头装不到位 | 调头后在标称位置就干涉 167.15 mm³（阈值 20.0）；销径 后 Ø4.0 / 前 Ø5.0，销位 y=-16 / 14（不对称） |
| ✅ | `POKA-02` | 滑盖上下颠倒装不进去 | 21.90 mm³ |
| ✅ | `POKA-02` | 滑盖前后调头装不进去 | 22.80 mm³ |
| ✅ | `POKA-03` | 草帽 LED 极性装反压不进去 | 装反时法兰被挡 0.40mm = 灯珠半径 2.90 − 座孔切边 2.50（要求 ≥0.30）；对应干涉体积仅 1.19 mm³，所以不用体积做判据 |
| ✅ | `POKA-04` | 开发板绕光轴转 180° 装不进去 | 481.55 mm³ |
| ✅ | `POKA-05` | 开发板前后装反时摄像头方腔是空的（装错一眼看得出） | 反装时方腔占用 0.00 mm³（正装 307.75 mm³）—— 镜头没有归位，板卡在腔里前后自由晃动 |
| ✅ | `POKA-06` | 镜片朝向只能靠刻字提醒 | 托板横梁上刻有 COATED SIDE DOWN；ASSEMBLY.md 第 11 步有对应检查动作。识别方法：用笔尖轻触镜面，笔尖和倒影**没有间隙**的那面才是镀膜面。 |

## WIRE · 走线

| | 编号 | 检查项 | 数值 |
|---|---|---|---|
| ✅ | `WIRE-01` | LED 引线通道与立板走线槽连通 | 座孔 ∪ 走线槽 = 1 个连通域（应为 1） |
| ✅ | `WIRE-02` | 整条走线路径连通：LED → 立板 → 吊臂 → 吊舱 | 座孔 ∪ 走线槽 ∪ 吊臂腔 ∪ 吊舱腔 = 1 个连通域（应为 1） |
| ✅ | `WIRE-03` | 电源进线孔在吊舱底面（防结露倒灌） | 进线孔自底面 z=-11.5 通到腔底 z=-9.0，开口朝下 |
| ✅ | `WIRE-04` | 走线槽全部开在内表面，外观面无槽 | 外表面薄层内的槽体积 0.00 mm³ |
