zomco/aiontheedge-firmware/cases/watermeter-dn25.step

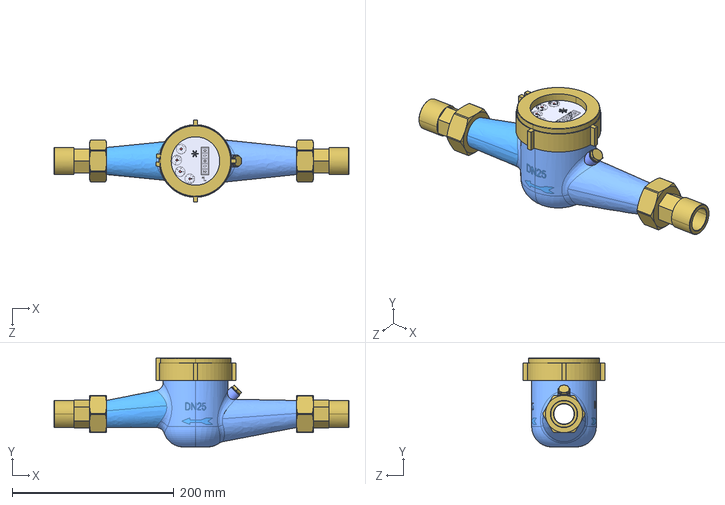
[picture p1: CAD file, 2026-09-08]
cases/watermeter-dn25.step
365.0 x 110.0 x 100.9 mm
