zomco/aiontheedge-firmware/cases/led.step

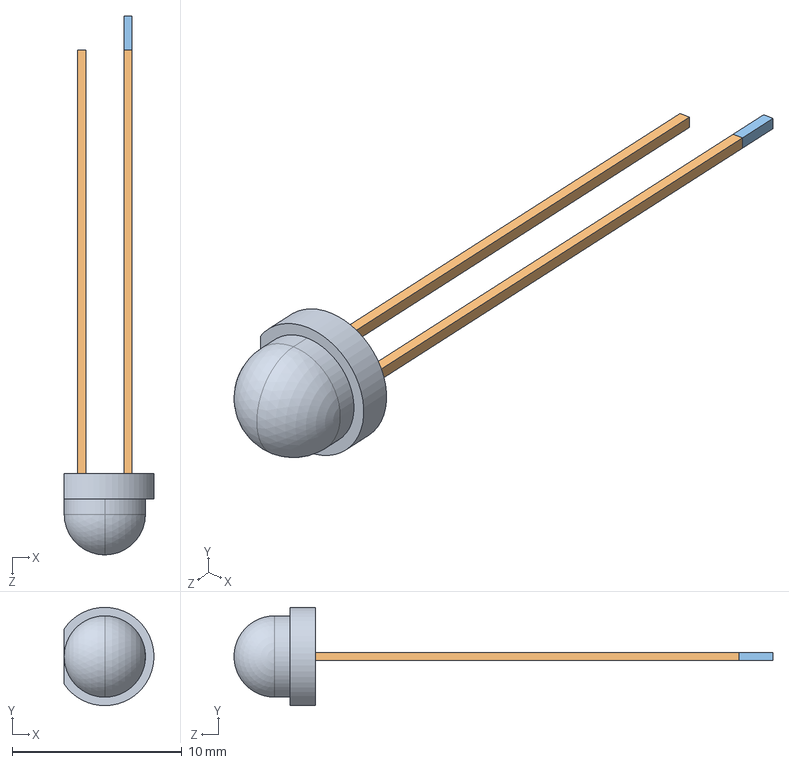
[picture p2: CAD file, 2026-09-08]
cases/led.step
5.29 x 5.80 x 31.8 mm
