zomco/aiontheedge-firmware/cases/esp32s3cam-2.step

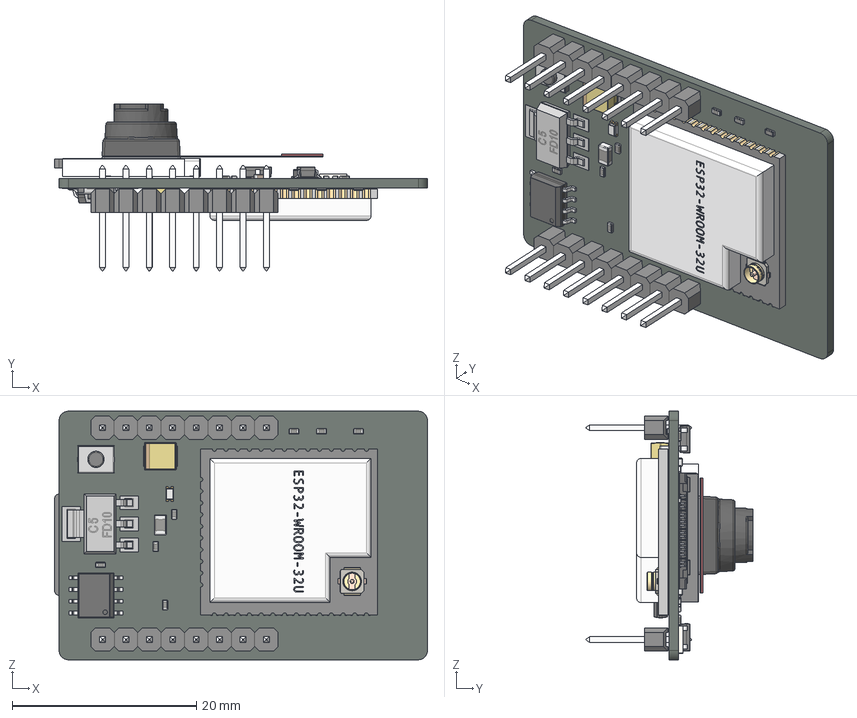
[picture p3: CAD file, 2026-09-08]
cases/esp32s3cam-2.step
40.5 x 18.1 x 27.0 mm
Pin Header 4 x 1 TH 2.54mm Pitch v1 x 4
u
capacitor-CAPM-TANTB-YL v1
switch-3x4x2mm - 2 Pad v1
nano - reg
icbody
Component5(Mirror) x 4
resistor-NTC-0402-T0.6 v1 x 20
resistor-NTC-0805-T1.3 v1
smd-transistor-SOT23-3 v1 x 4
capacitor-CAPC-0603-T0.9-BN v1 x 2
connector smd usl00-20l_p0-4_l12-6_w2-75 v1
sdreader
Micro SD-Card v1
User Library-ov9655_ov9655_flex_pcb
User Library-ov9655_ov9655_flex_reinf
User Library-ov9655_ov9655_back_panel
User Library-ov9655_ov9655_body
User Library-ov9655_ov9655_lens
Anode
Cathode
Light
