zomco/aiontheedge-firmware/cases/esp32s3cam-3.step

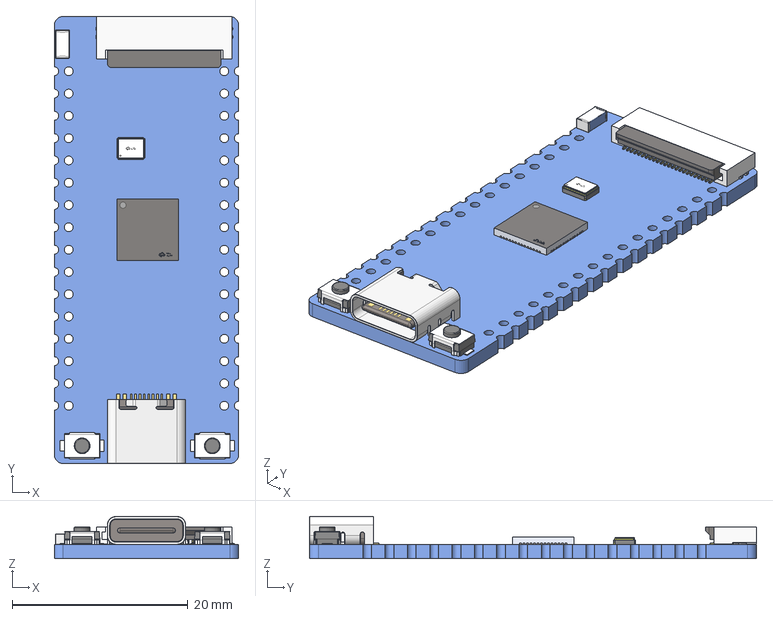
[picture p4: CAD file, 2026-09-08]
cases/esp32s3cam-3.step
21.0 x 50.9 x 4.80 mm
