zomco/aiontheedge-firmware/cases/CHANGELOG.md

# 变更记录

格式：每个版本记「改了什么 / 为什么 / 谁发现的 / 新增了哪条自检」。
最后一条最重要 —— **每个试打发现的问题都必须先变成一条自检规则**，
否则同一个错误会在下一版重现。

---

## v3.0.0 —— build123d 参数化包 + 110 项自检（本次重构）

### 结构性变化

* 单文件 `wm_rig.py`（824 行）拆成分层的 `wmcase/` 包：
  `params → layout → geometry → parts/refs → model → checks/optics/export/report`，
  依赖方向严格自上而下。
* **所有尺寸集中到 `params.py`**，并按可信度分四类标注
  （`[实测]` / `[采购]` / `[设计]` / `[估算]`）。
* 尺寸链单独成层（`layout.py`），建模和自检共用同一份推导。
* 自检从 32 项扩到 **110+ 项 / 10 个分类**，新增 SEQ（装配顺序）、
  POKA（防呆）、WIRE（走线连通）、DFAM（悬垂 + 壁厚）四类。
* 装配顺序写成数据（`assembly.py`），`ASSEMBLY.md` 由它生成，
  同时也是 SEQ 自检的输入 —— 文档和模型不可能不一致。
* 新增**光路仿真**：虚拟相机 + 逐点光线追踪，产出 `out/sensor_view.svg`。
* 入口统一为 `build.py`（check / build / sim / params / doc / inspect）。

### 设计变化（都是被自检逼出来的）

| # | 改动 | 为什么 | 谁发现的 |
|---|---|---|---|
| 1 | 吊舱前腔按**真实**摄像头模组（8.5×8.5）重做，并拆成深/浅两级让位槽 | 上一版按"模组 27×27"建腔 —— 那其实是整块 PCB 的宽度。按 27 建的腔既夹不住模组（光轴定位失效），也挡不住 PCB（止挡失效） | 从 `esp32s3cam-2.step` 里实测 |
| 2 | PCB 前表面止挡改到 **Z<18.8 的下缘带**，不再是四周一圈 | 前侧贴片元件一直铺到 X±12.81，而 PCB 只有 ±13.5，两侧根本剩不下台阶 | `FIT-06` 报出十几处 <0.5mm³ 的干涉 |
| 3 | **两个镜托台改成等高**，"三角耳 + 支承脚"合并成一片支承片 | ★ 原设计的镜片托板**根本拿不出来**：抽出时低的那半段会扫过高的托台，需要抬升 >30mm，天花板只给 11mm | `SEQ-02`（抄表流程路径仿真）；静态干涉一条都没报 |
| 4 | LED 高度 30 → 20 | 灯座凸台伸到 X≈37，正好在支承片平推的路径上。降到 z=20 后凸台落到 z<27，支承片抬 8mm 即可掠过。顺带把入射角从 51.7° 提到 62.2°，镜面反射瓣偏得更远 | 同上 |
| 5 | 滑盖防呆定位筋从槽中段挪到**紧贴槽底** | 放中段会把**正装**也一起挡住 —— 盖板从上往下滑，满宽舌片一定先撞上它 | `SEQ-01` 第 9 步 |
| 6 | 反射面基准从"托板正面"改到"**镜片镀膜面**" | 原来的定义让实际反射面比设计平面退后 0.8mm，光线追踪直接打空 | `OPT-01` 光线追踪（体积法和肉眼都看不出来） |
| 7 | 托板提手从中间挪到两侧 + 横梁 | 中间是 T 型槽插入口，横穿过去会被槽切断（托板裂成 2 个孤立实体），也会挡住镜片滑入 | `TOPO-01` |
| 8 | LED 座孔加**极性切边**（Ø6.0，切边距轴心 2.5） | 装反时法兰被挡 0.40mm，物理上压不进去 | 新增防呆 |
| 9 | 前后定位销直径不同（后 Ø4 / 前 Ø5） | 托板前后调头装不上 | 新增防呆 |
| 10 | EVA 泡棉 3mm → 12mm | 3mm 根本够不着板卡（盖板到板卡最后端有 10.31mm） | `FIT-09` 尺寸链核算 |
| 11 | 吊臂改成**三段**（先贴立板外侧前伸，越过托板抽出范围后再收进来） | 原来的斜杆正好横穿托板每月抽出时扫过的空间 | `SEQ-02` 报出 1053mm³ 干涉 |
| 12 | 吊臂 U 型腔在吊舱端的 X 从 18 挪到 19 | 骑在型腔边界（X=17）上时，腔和型腔各切一半，中间留下零点几毫米薄壁 —— STEP 完全合法，3MF 网格化直接失败 | 导出时 lib3mf 报错，随后补成自检 `TOPO-04` |

### 工具坑（都值得记住）

* **`import_step` 返回的嵌套 Compound 直接做布尔会静默返回空集。**
  `body & board` 恒等于 0，所有关于开发板的干涉检查一起"通过" ——
  最危险的假阴性。修法：`refs.load_step_fused()` 先把实体熔成一个 Part。
  发现线索：三条互相独立的检查（板卡 −Y/±X/−Z 约束）同时报出同一个可疑的 0。
* **反向判据的阈值必须比正向容差高一个量级**，否则那条检查是假的。
  LED 极性防呆的干涉体积不到 1mm³，而"不干涉"的容差是 2mm³ ——
  只能改用**线性阻挡量**做判据。
* **反向判据的方向要想清楚。** `POKA-01`（托板调头）第一版写成"应当干涉"，
  而实际失败模式是"会悬空"，判据方向完全相反 —— 那条检查永远为假。
* **不要为了做碰撞检测先把场景 union 起来。** union 本身就是最贵的布尔，
  逐个求交再相加结果一样，但快两个数量级（20 分钟 → 20 秒，内存 3GB → 正常）。
* **`Axis` 求交返回的是整条直线的交点**（包含反向），必须自己按参数 t 过滤。
* **STEP 合法 ≠ 网格合法**，而切片器吃的是网格。`is_valid=True` + `solids==1`
  + 干涉全过 + STEP 正常导出，网格化照样可能失败。
  推论：**两个减法体不要只在一个平面上相切**，宁可让它们有几毫米体积重叠。
  已补成自检 `TOPO-04`。

### 还没做的

* 桥接跨度没有自动检查（靠切片预览）
* 壁厚 / 悬垂是**采样**，不是证明
* `esp32s3cam-1` / `-3` 还没适配（第一版只适配 `-2`）
* 蓝盖翻开停放的位置仍是估算 —— **当前风险最高的一条未验证假设**（`FIT-14`）

---

## 试打记录

> 每次试打在这里加一条。建议按 [WORKFLOW.md §4.1](WORKFLOW.md) 的
> T1（抱箍）→ T2（托板）→ T3（吊舱）→ T4（整机）顺序分批打。

```
## T1 抱箍试件（YYYY-MM-DD）
- 打印：材料 / 层高 / 圈数
- 结果：
- 实测：
- 结论：参数 X 从 ? 改成 ?
- 新增自检：（如果发现了新的错误类别）
```

（暂无）

---

## v2.x 及更早

见 [DESIGN_NOTES.md §8 架构演进史](DESIGN_NOTES.md)。
每一版的死因都记在那里，因为它们标记了设计空间的边界。
