zomco/aiontheedge-firmware/cases/amico-lxsy.pdf

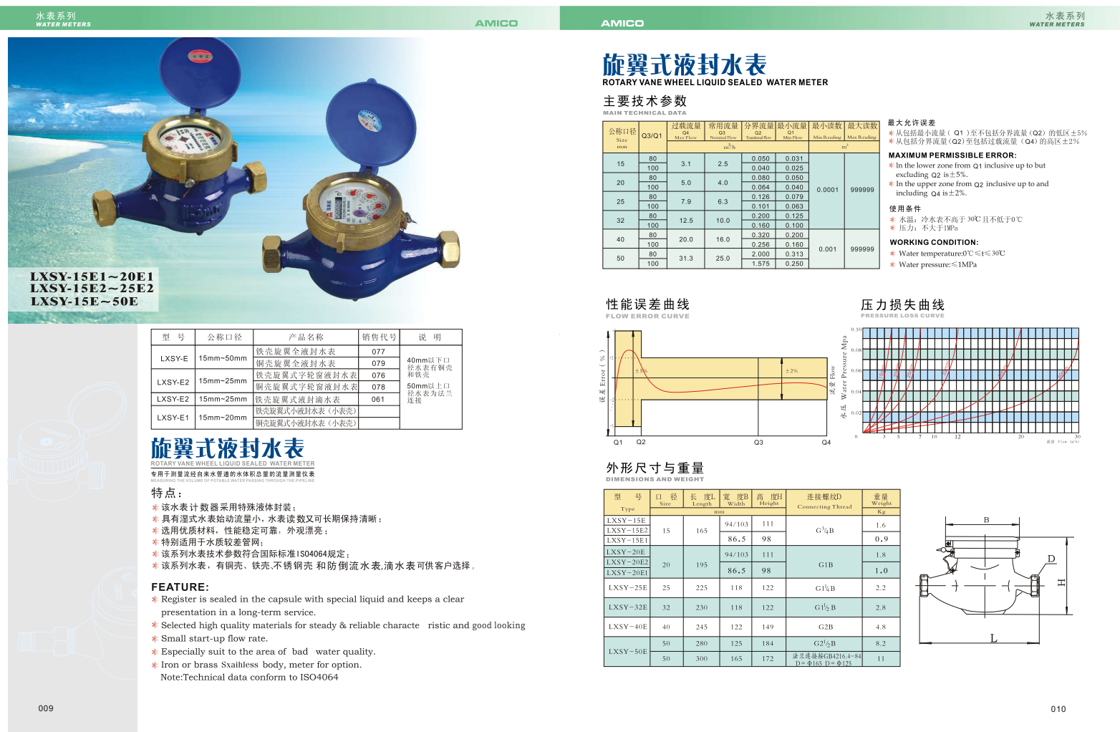
[picture p5: page 1]
