zomco/aiontheedge-firmware/cases/wmcase/refs.py

# -*- coding: utf-8 -*-
"""
参考件模型 —— 我们**不生产**、但设计必须绕开的东西。

三种可信度，代码里严格区分（这一条是硬规矩）：

===============  ===========================================================
``AUTHORITATIVE``  厂家 STEP，尺寸可信 → **可以**作为自检的判定依据
``MOCK``           我们按卡尺实测数据参数化搭的替身 → **可以**判定
``ILLUSTRATIVE``   形似但尺寸不对的模型 → **只能**看，不许进判定
===============  ===========================================================

第三类目前只有 ``watermeter-dn25.step``：它的表盘外观和 LXSY-15E2 很像，
但那是 **DN25**，实测用表是 **DN15**。放进装配体供人眼检视没问题，
拿它算干涉就是自欺欺人。:func:`meter_mock` 才是判定用的水表模型。
"""

from __future__ import annotations

import os
from dataclasses import dataclass
from functools import lru_cache

from build123d import Box, Cylinder, Location, Part, Pos, Rot, import_step

from .geometry import bx, cyl_z, mirror_x
from .layout import board_location, led_frame, mirror_frame
from .params import Config

AUTHORITATIVE = "authoritative"
MOCK = "mock"
ILLUSTRATIVE = "illustrative"


@dataclass
class RefModel:
    """一个参考件：形体 + 它有多可信 + 从哪来。"""

    name: str
    shape: Part
    trust: str
    source: str

    @property
    def usable_for_checks(self) -> bool:
        return self.trust in (AUTHORITATIVE, MOCK)


# =============================================================================
#  STEP 载入（带缓存，STEP 解析很贵）
# =============================================================================

def _refs_root(cfg: Config) -> str:
    """参考模型目录（默认就是 ``cases/`` 本身）。"""
    here = os.path.dirname(os.path.dirname(os.path.abspath(__file__)))
    return os.path.normpath(os.path.join(here, cfg.refs_dir))


@lru_cache(maxsize=8)
def _load_step(path: str):
    return import_step(path)


def load_step(cfg: Config, filename: str):
    """载入 ``cases/`` 下的一个 STEP。找不到返回 None（调用方负责降级）。"""
    path = os.path.join(_refs_root(cfg), filename)
    if not os.path.isfile(path):
        return None
    return _load_step(path)


@lru_cache(maxsize=8)
def _fused(path: str) -> Part:
    """
    把 STEP 里成百上千个零散实体**熔成一个** Part。

    ⚠ 这一步不是优化，是**正确性**问题。``import_step`` 返回的嵌套 Compound
    直接参与布尔运算时，OCC 会静默地返回空集：``body & board`` 恒等于 0，
    于是所有关于开发板的干涉检查全部"通过"——这是最危险的一类假阴性，
    因为它长得和"设计没问题"一模一样。

    发现它的过程：CONS-07/08/09（板卡三个方向的约束）同时报 0 干涉。
    三条独立的检查同时给出同一个可疑答案，基本可以断定是工具问题而不是设计问题。
    """
    shp = _load_step(path)
    return Part() + shp.solids()


def load_step_fused(cfg: Config, filename: str) -> Part | None:
    """载入并熔合。**任何要参与布尔运算的 STEP 都必须走这里。**"""
    path = os.path.join(_refs_root(cfg), filename)
    if not os.path.isfile(path):
        return None
    return _fused(path)


# =============================================================================
#  开发板
# =============================================================================

def board(cfg: Config) -> RefModel:
    """
    ESP32-S3-CAM 开发板，已摆到全局坐标里。

    姿态由 :func:`layout.board_location` 给出，**不做任何自动对齐**——
    自动对齐（比如"把包围盒中心搬到某处"）看起来省事，但它会掩盖
    "这块板和 BoardSpec 对不上"这件事。宁可硬编码变换 + 自检核对包络。
    """
    shp = load_step_fused(cfg, cfg.board.step_file)
    if shp is None:
        return RefModel(
            name="board",
            shape=board_mock(cfg),
            trust=MOCK,
            source=f"参数替身（找不到 {cfg.board.step_file}）",
        )
    return RefModel(
        name="board",
        shape=board_location(cfg) * shp,
        trust=AUTHORITATIVE,
        source=cfg.board.step_file,
    )


def board_mock(cfg: Config) -> Part:
    """
    没有 STEP 时的兜底替身：只有 PCB + 摄像头模组 + 背面包络三块。
    刻意做得"方"，因为它的用途是**保守**地占位，不是精确表达。
    """
    from .layout import pod_layout

    p = pod_layout(cfg)
    b = cfg.board
    pcb = bx(-p.pcb_half_x, p.pcb_half_x, p.pcb_face_y, p.pcb_back_y, p.pcb_z0, p.pcb_z1)
    holder = bx(-b.holder_sq / 2, b.holder_sq / 2,
                cfg.optics.lens_face_y, p.holder_back_y,
                cfg.optics.mirror_z - b.holder_sq / 2, cfg.optics.mirror_z + b.holder_sq / 2)
    back = bx(-p.pcb_half_x, p.pcb_half_x, p.pcb_back_y, p.board_back_y,
              p.pcb_z0 + 2, p.pcb_z1 - 2)
    return pcb + holder + back


# =============================================================================
#  LED（5mm 草帽白光）
# =============================================================================

def led_pair(cfg: Config) -> RefModel:
    """左右两颗 LED，已摆到灯座里。"""
    shp = load_step_fused(cfg, "led.step")
    if shp is None:
        one = led_mock(cfg)
        src = "参数替身（找不到 led.step）"
        trust = MOCK
    else:
        one = led_frame(cfg) * shp
        src = "led.step"
        trust = AUTHORITATIVE
    return RefModel(name="led_pair", shape=mirror_x(Part() + one), trust=trust, source=src)


def led_bodies(cfg: Config) -> Part:
    """
    只保留灯珠**本体**（法兰 + 穹顶），砍掉 25mm 长引脚。

    干涉判定必须用这个而不是完整模型：引脚是可以随便弯的软线，
    它穿过立板"干涉"了几立方毫米不是设计缺陷；而法兰能不能坐进座孔、
    极性切边对不对得上，才是真问题。
    """
    lg = cfg.light
    loc = led_frame(cfg)
    keep = loc * Pos(0, 0, (lg.body_h + 1.0) / 2 - 0.5) * \
        Box(3 * lg.flange_d, 3 * lg.flange_d, lg.body_h + 1.0)
    return mirror_x(Part() + (led_frame(cfg) * _led_solid(cfg))) & mirror_x(Part() + keep)


def _led_solid(cfg: Config):
    """灯珠在自身局部坐标里的形体（有 STEP 用 STEP，没有就用替身）。"""
    shp = load_step_fused(cfg, "led.step")
    if shp is not None:
        return shp
    lg = cfg.light
    return (Pos(0, 0, lg.flange_h / 2) * Cylinder(lg.flange_d / 2, lg.flange_h)
            + Pos(0, 0, lg.body_h / 2) * Cylinder(lg.body_d / 2, lg.body_h))


def led_mock(cfg: Config) -> Part:
    """按 Lighting 参数搭的灯珠替身：法兰 + 灯体 + 两根引脚。"""
    lg = cfg.light
    loc = led_frame(cfg)
    flange = loc * Pos(0, 0, lg.flange_h / 2) * Cylinder(lg.flange_d / 2, lg.flange_h)
    body = loc * Pos(0, 0, lg.body_h / 2) * Cylinder(lg.body_d / 2, lg.body_h)
    leads = Part()
    for s in (-1, 1):
        leads += (loc * Pos(s * lg.lead_pitch / 2, 0, -lg.lead_len / 2)
                  * Box(lg.lead_sq, lg.lead_sq, lg.lead_len))
    return flange + body + leads


# =============================================================================
#  反射镜（外购前表面镜）
# =============================================================================

def mirror_glass(cfg: Config, slide: float = 0.0, push_out: float = 0.0) -> Part:
    """
    反射镜实体。

    **镀膜面 = 局部 z = 0 的那一面**，也就是 ``layout.mirror_frame`` 的基准平面
    ``z = y + mirror_z``。光线追踪、镜片口径判定全都依赖这个约定，
    改它之前请先读 ``parts/mirror_holder.py`` 顶部关于局部 z 零点的说明。

    :param slide:    沿局部 −Y 滑出的距离（T 型槽的装配方向）
    :param push_out: 沿局部 +Z 向外推的距离（用来验证唇口真的兜得住）
    """
    o = cfg.optics
    z_center = -o.mirror_t / 2 + push_out
    return (mirror_frame(cfg) * Pos(0, slide, z_center)
            * Box(o.mirror_w, o.mirror_l, o.mirror_t))


def mirror_ref(cfg: Config) -> RefModel:
    return RefModel(
        name="mirror_glass",
        shape=mirror_glass(cfg),
        trust=MOCK,
        source=f"外购前表面镜 {cfg.optics.mirror_l:.0f}×{cfg.optics.mirror_w:.0f}"
               f"×{cfg.optics.mirror_t:.0f}",
    )


# =============================================================================
#  水表
# =============================================================================

def meter_mock(cfg: Config) -> RefModel:
    """
    **判定用**的水表替身，完全由卡尺实测数据搭出来：

    * 银圈：外径 82.1 / 内径 61.8 / 高 21.1 的圆环
    * 底部凸台：宽 9.5 高 2.8 的一圈（夹持带必须避开）
    * 表体：按样本 L165 × B94 × H111 的方块包络（用来验抱箍不会撞表体）

    刻意**不建**蓝盖翻开后的姿态——那个尺寸还是估算（cover_open_top），
    真要验证请先实测，然后把它变成这里的实体。
    """
    m = cfg.meter
    ring = cyl_z(0, 0, m.bezel_bottom_z, m.bezel_top_z, m.bezel_od)
    ring -= cyl_z(0, 0, m.bezel_bottom_z - 1, m.bezel_top_z + 1, m.bezel_id)
    boss = cyl_z(0, 0, m.bezel_bottom_z, m.boss_top_z, m.bezel_od + 2 * m.boss_w)
    boss -= cyl_z(0, 0, m.bezel_bottom_z - 1, m.boss_top_z + 1, m.bezel_od)
    # 表体：以表盘中心为参照的粗包络。高度自银圈底面往下 H − bezel_h。
    body_top = m.bezel_bottom_z
    body_bot = body_top - (m.body_height - m.bezel_h)
    body = bx(-m.body_len / 2, m.body_len / 2,
              -m.body_width / 2, m.body_width / 2,
              body_bot, body_top)
    return RefModel(name="meter", shape=ring + boss + body, trust=MOCK,
                    source=f"{m.model} 卡尺实测 + 样本外形表")


def meter_illustrative(cfg: Config) -> RefModel | None:
    """
    ``watermeter-dn25.step`` —— 只用于人眼检视，**任何自检都不许引用**。
    它是 DN25，实测用表是 DN15，表头尺寸对不上。
    """
    shp = load_step(cfg, "watermeter-dn25.step")   # 仅用于装配体展示，不参与布尔
    if shp is None:
        return None
    return RefModel(name="meter_dn25_illustrative", shape=shp, trust=ILLUSTRATIVE,
                    source="watermeter-dn25.step（DN25，仅供外观参考）")
