zomco/aiontheedge-firmware/(commit log)

2026-08-18 Add esp32-s3-cam
2026-09-04 Add cases
    [assembly.step, body.3mf, mirror_holder.3mf, slide_cover.3mf]
2026-09-08 重构外壳设计：build123d 参数化包 + 117 项自检 + 光路仿真
    把 cases/ 变成自足的外壳设计工作目录：单文件 wm_rig.py 拆成分层的
    wmcase/ 包，自检从 32 项扩到 117 项，新增装配顺序仿真、防呆验证、
    走线连通性和光线追踪。
    结构
    - params → layout → geometry → parts/refs → model → checks/optics/export/report
    - 所有尺寸集中在 params.py，按可信度标注 [实测]/[采购]/[设计]/[估算]
    - 装配顺序写成数据（assembly.py），ASSEMBLY.md 由它生成，同时也是
    SEQ 自检的输入，文档和模型不会各说各话
    - 入口统一为 build.py（check/build/sim/params/doc/inspect）
    - CI 在 cas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
    [assembly.step, body.3mf, esp32s3cam-2.step, esp32s3cam-3.step, led.step, mirror_holder.3mf, slide_cover.3mf, watermeter-dn25.step]
